keerthnam/Spatial-Mapping-System/README.md

The system functions as a budget-friendly embedded LiDAR room scanner which creates
three-dimensional spatial maps of indoor spaces. The microcontroller MSP432E401Y serves as
the central hub which manages all system operations by controlling stepper motors and gathering
ToF sensor data and displaying LED status and sending UART data to a connected PC.
